lahirunirmalx/la4440-stereo-amp/kicad/la4440-schematic.pdf

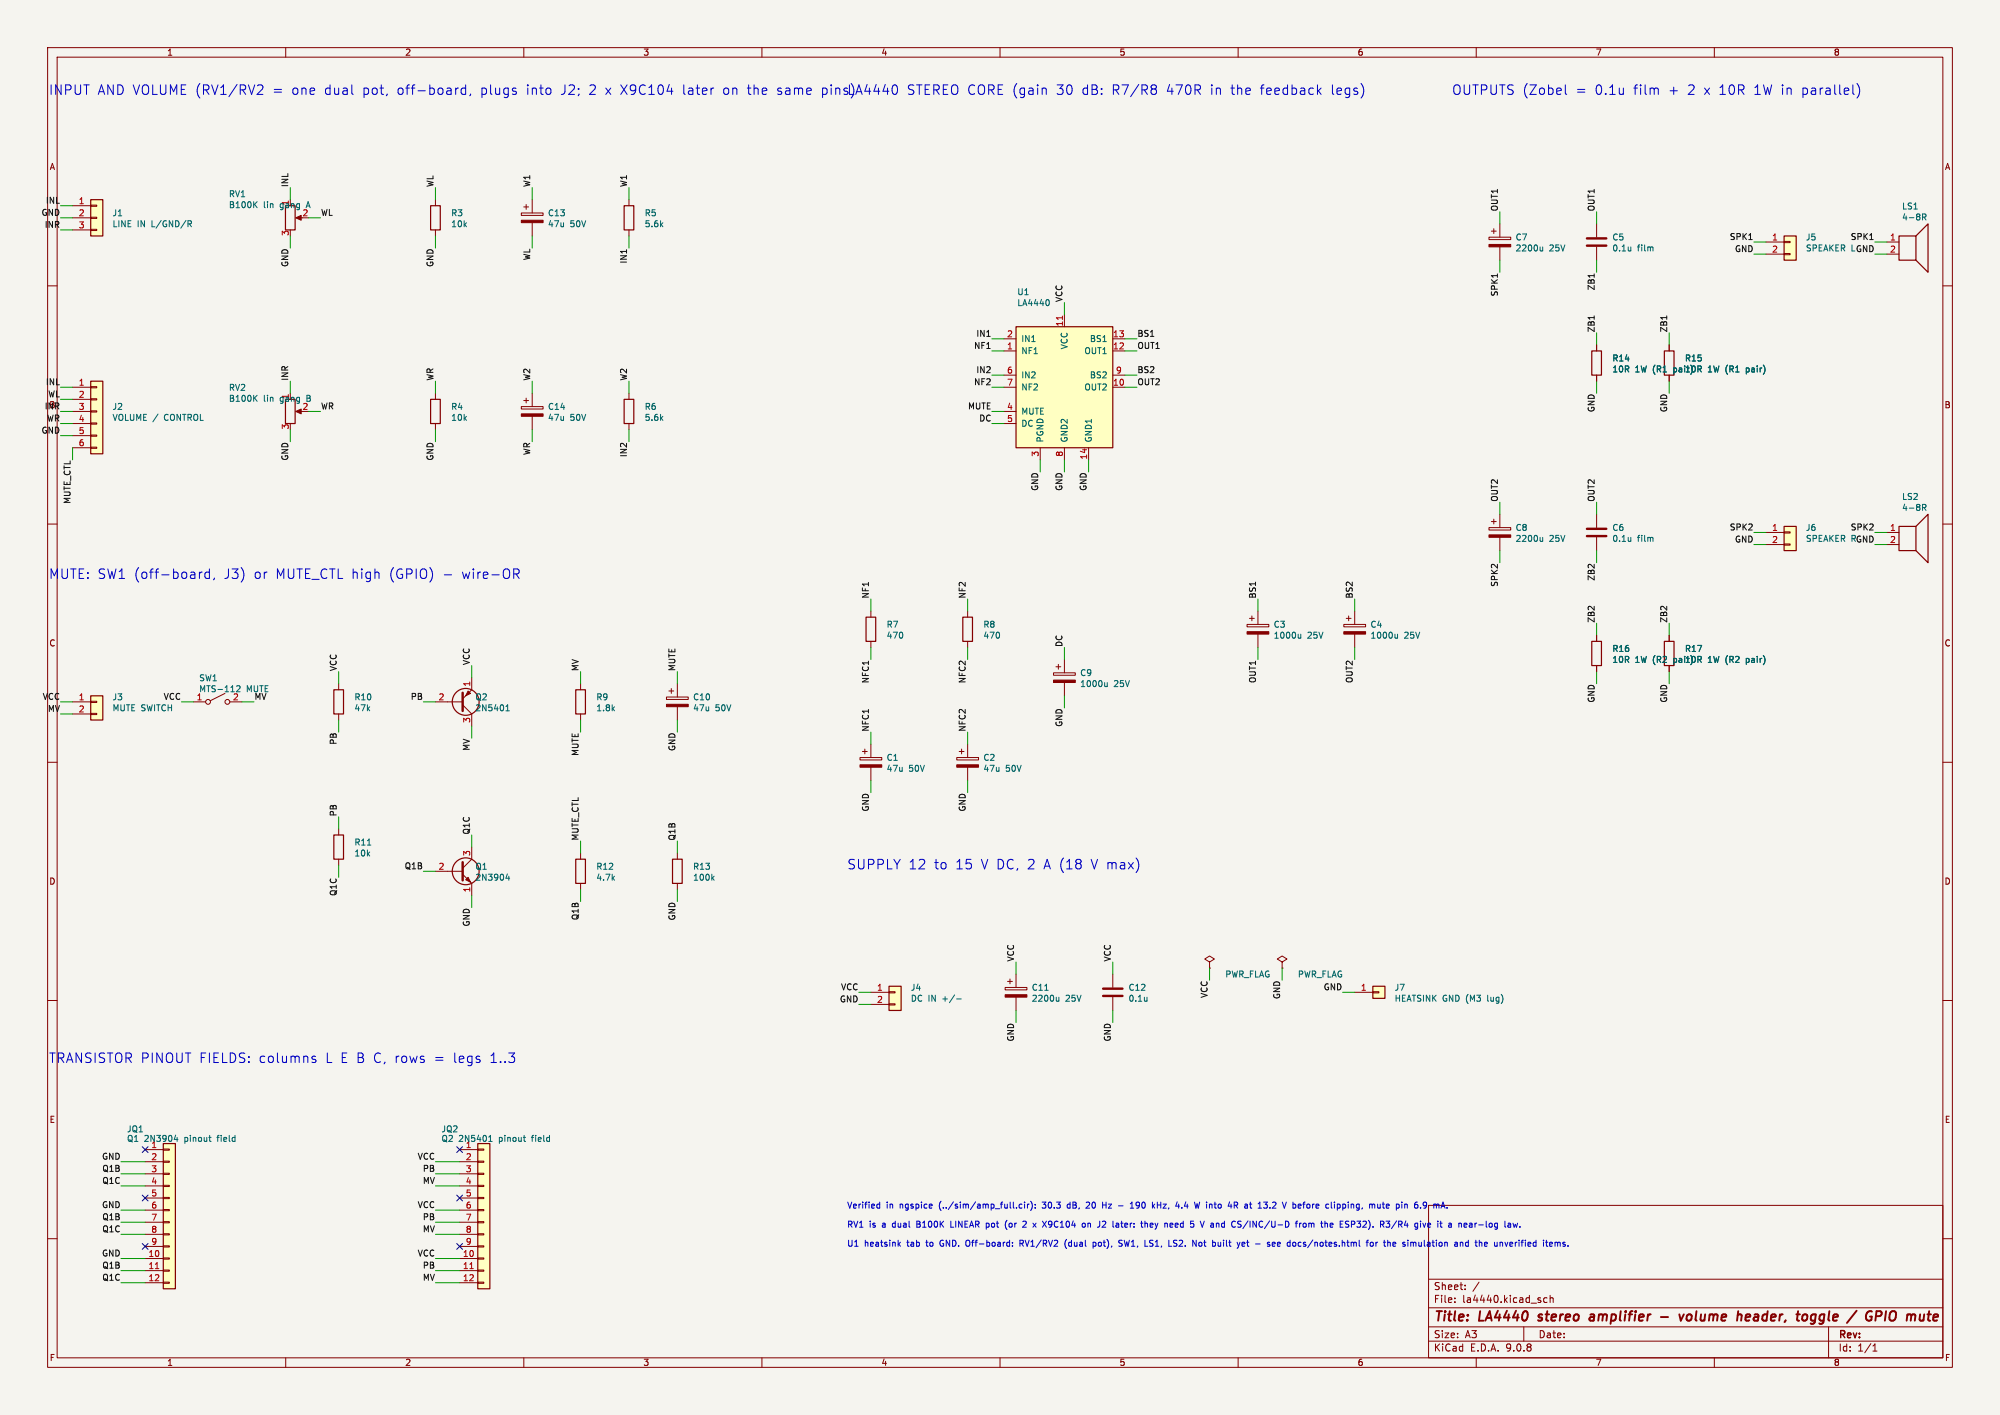
[picture p5: page 1]

SUPPLY 12 to 15 V DC, 2 A (18 V max)

File: la4440.kicad_sch Sheet: /
Id: 1/1 Title: LA4440 stereo amplifier - volume header, toggle / GPIO mute
