lahirunirmalx/la4440-stereo-amp/kicad/la4440.kicad_pcb

## KiCad design kicad/la4440.kicad_pcb (2026-10-28)

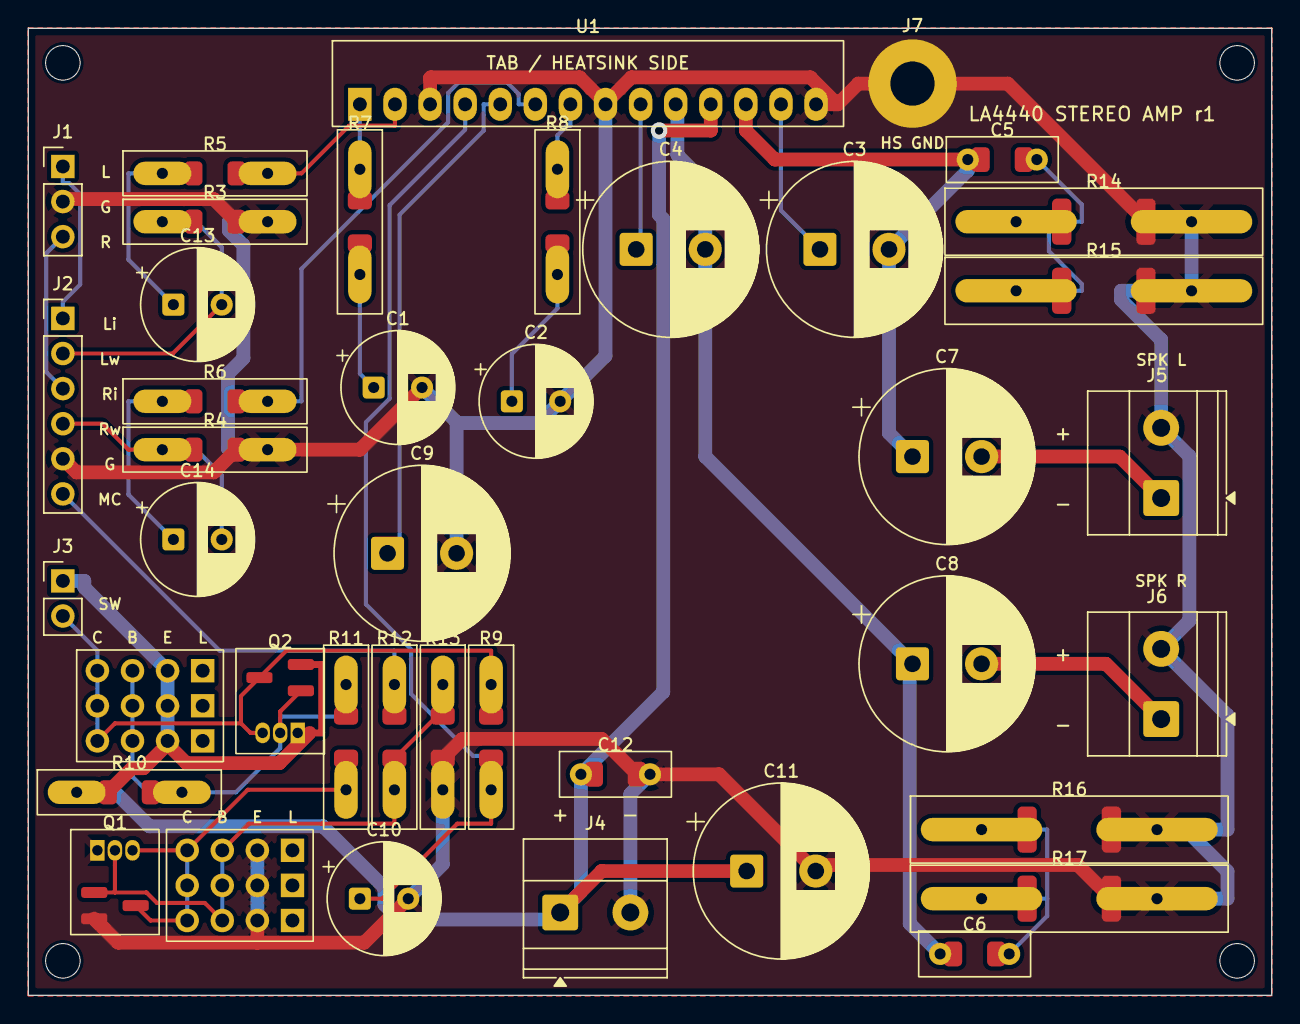
[picture p6: board la4440.kicad_pcb from above]

Board: 2 copper layers, 90.0 x 70.0 mm, 45 parts (0 on the bottom side), 29 nets.

Parts:
C1, C2, C10, C13, C14: 47u 50V; CP_Radial_D8.0mm_P3.50mm
C3, C4, C9: 1000u 25V; CP_Radial_D12.5mm_P5.00mm
C5, C6: 0.1u film; C_Rect5_1206
C7, C8, C11: 2200u 25V; CP_Radial_D12.5mm_P5.00mm
C12: 0.1u; C_Rect5_1206
H1, H2, H3, H4: M2.5; Hole_2.5mm
J1: LINE IN L/GND/R; PinHeader_1x03_P2.54mm_Vertical
J2: VOLUME / CONTROL; PinHeader_1x06_P2.54mm_Vertical
J3: MUTE SWITCH; PinHeader_1x02_P2.54mm_Vertical
J4: DC IN +/-; TerminalBlock_Phoenix_MKDS-1,5-2-5.08_1x02_P5.08mm_Horizont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
J5: SPEAKER L; TerminalBlock_Phoenix_MKDS-1,5-2-5.08_1x02_P5.08mm_Horizont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
J6: SPEAKER R; TerminalBlock_Phoenix_MKDS-1,5-2-5.08_1x02_P5.08mm_Horizont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
J7: HEATSINK GND (M3 lug); MountingHole_3.2mm_M3_Pad
JQ1: Q1 2N3904 pinout field; JQ_3x4
JQ2: Q2 2N5401 pinout field; JQ_3x4
Q1: 2N3904; TO92_SOT23
Q2: 2N5401; TO92_SOT23
R3, R4, R11: 10k; R_Axial_1206
R5, R6: 5.6k; R_Axial_1206
R7, R8: 470; R_Axial_1206
R9: 1.8k; R_Axial_1206
R10: 47k; R_Axial_1206
R12: 4.7k; R_Axial_1206
R13: 100k; R_Axial_1206
R14, R15: 10R 1W (R1 pair); R_Axial10_2512
R16, R17: 10R 1W (R2 pair); R_Axial10_2512
U1: LA4440; SIP14H_LA4440

Connections:
/BS1: C3.1, U1.13
/BS2: C4.1, U1.9
/DC: C9.1, U1.5
/GND: C1.2, C2.2, C9.2, C10.2, C11.2, C12.2, C12.2S, J1.2, J2.5, J4.2, J5.2, J6.2, J7.1, JQ1.2, JQ1.6, JQ1.10, Q1.1, Q1.1S, R3.2, R3.2S, R4.2, R4.2S, R13.2, R13.2S, R14.2, R14.2S, R15.2, R15.2S, R16.2, R16.2S, R17.2, R17.2S, U1.3, U1.8, U1.14
/IN1: R5.2, R5.2S, U1.2
/IN2: R6.2, R6.2S, U1.6
/INL: J1.1, J2.1
/INR: J1.3, J2.3
/MUTE: C10.1, R9.2, R9.2S, U1.4
/MUTE_CTL: J2.6, R12.1, R12.1S
/MV: J3.2, JQ2.4, JQ2.8, JQ2.12, Q2.3, Q2.3S, R9.1, R9.1S
/NF1: R7.1, R7.1S, U1.1
/NF2: R8.1, R8.1S, U1.7
/NFC1: C1.1, R7.2, R7.2S
/NFC2: C2.1, R8.2, R8.2S
/OUT1: C3.2, C5.1, C5.1S, C7.1, U1.12
/OUT2: C4.2, C6.1, C6.1S, C8.1, U1.10
/PB: JQ2.3, JQ2.7, JQ2.11, Q2.2, Q2.2S, R10.2, R10.2S, R11.1, R11.1S
/Q1B: JQ1.3, JQ1.7, JQ1.11, Q1.2, Q1.2S, R12.2, R12.2S, R13.1, R13.1S
/Q1C: JQ1.4, JQ1.8, JQ1.12, Q1.3, Q1.3S, R11.2, R11.2S
/SPK1: C7.2, J5.1
/SPK2: C8.2, J6.1
/VCC: C11.1, C12.1, C12.1S, J3.1, J4.1, JQ2.2, JQ2.6, JQ2.10, Q2.1, Q2.1S, R10.1, R10.1S, U1.11
/W1: C13.1, R5.1, R5.1S
/W2: C14.1, R6.1, R6.1S
/WL: C13.2, J2.2, R3.1, R3.1S
/WR: C14.2, J2.4, R4.1, R4.1S
/ZB1: C5.2, C5.2S, R14.1, R14.1S, R15.1, R15.1S
/ZB2: C6.2, C6.2S, R16.1, R16.1S, R17.1, R17.1S
