lahirunirmalx/la4440-stereo-amp/(commit log)

2026-10-28 LA4440 stereo amp r1: schematic, 90 x 70 mm board, simulation, fab files
    Volume on a 6-pin header (dual B100K linear now, 2 x X9C104 later), mute by
    toggle or GPIO on LA4440 pin 4, gain lowered to 30 dB with 470R feedback legs.
    KiCad netlist checked against sim/amp_full.cir, ERC 0, DRC 0 with schematic
    parity. Simulated only - not built or measured.
    [la4440-panel-2up.kicad_pcb, la4440.kicad_pcb, la4440.kicad_sch]
2026-10-28 Label every jack and terminal pin on the silkscreen; drop the README 'not verified' section
    J1 L/G/R, J2 Li/Lw/Ri/Rw/G/MC, J3 SW, J4 and speaker +/-. Q2 emitter link
    is now a locked pre-routed stub (gen_pcb.py) instead of a post-route patch,
    so a rebuild no longer depends on where freerouting lands. DRC 0 with parity.
    [la4440-panel-2up.kicad_pcb, la4440.kicad_pcb, la4440.kicad_sch]
2026-10-28 BOM: drop the author's stock column, add quantities and a shopping list
